Kylevdm/esp-power-hub/ESP Power Hub v2.kicad_pcb

## KiCad design ESP Power Hub v2.kicad_pcb (2026-02-04)

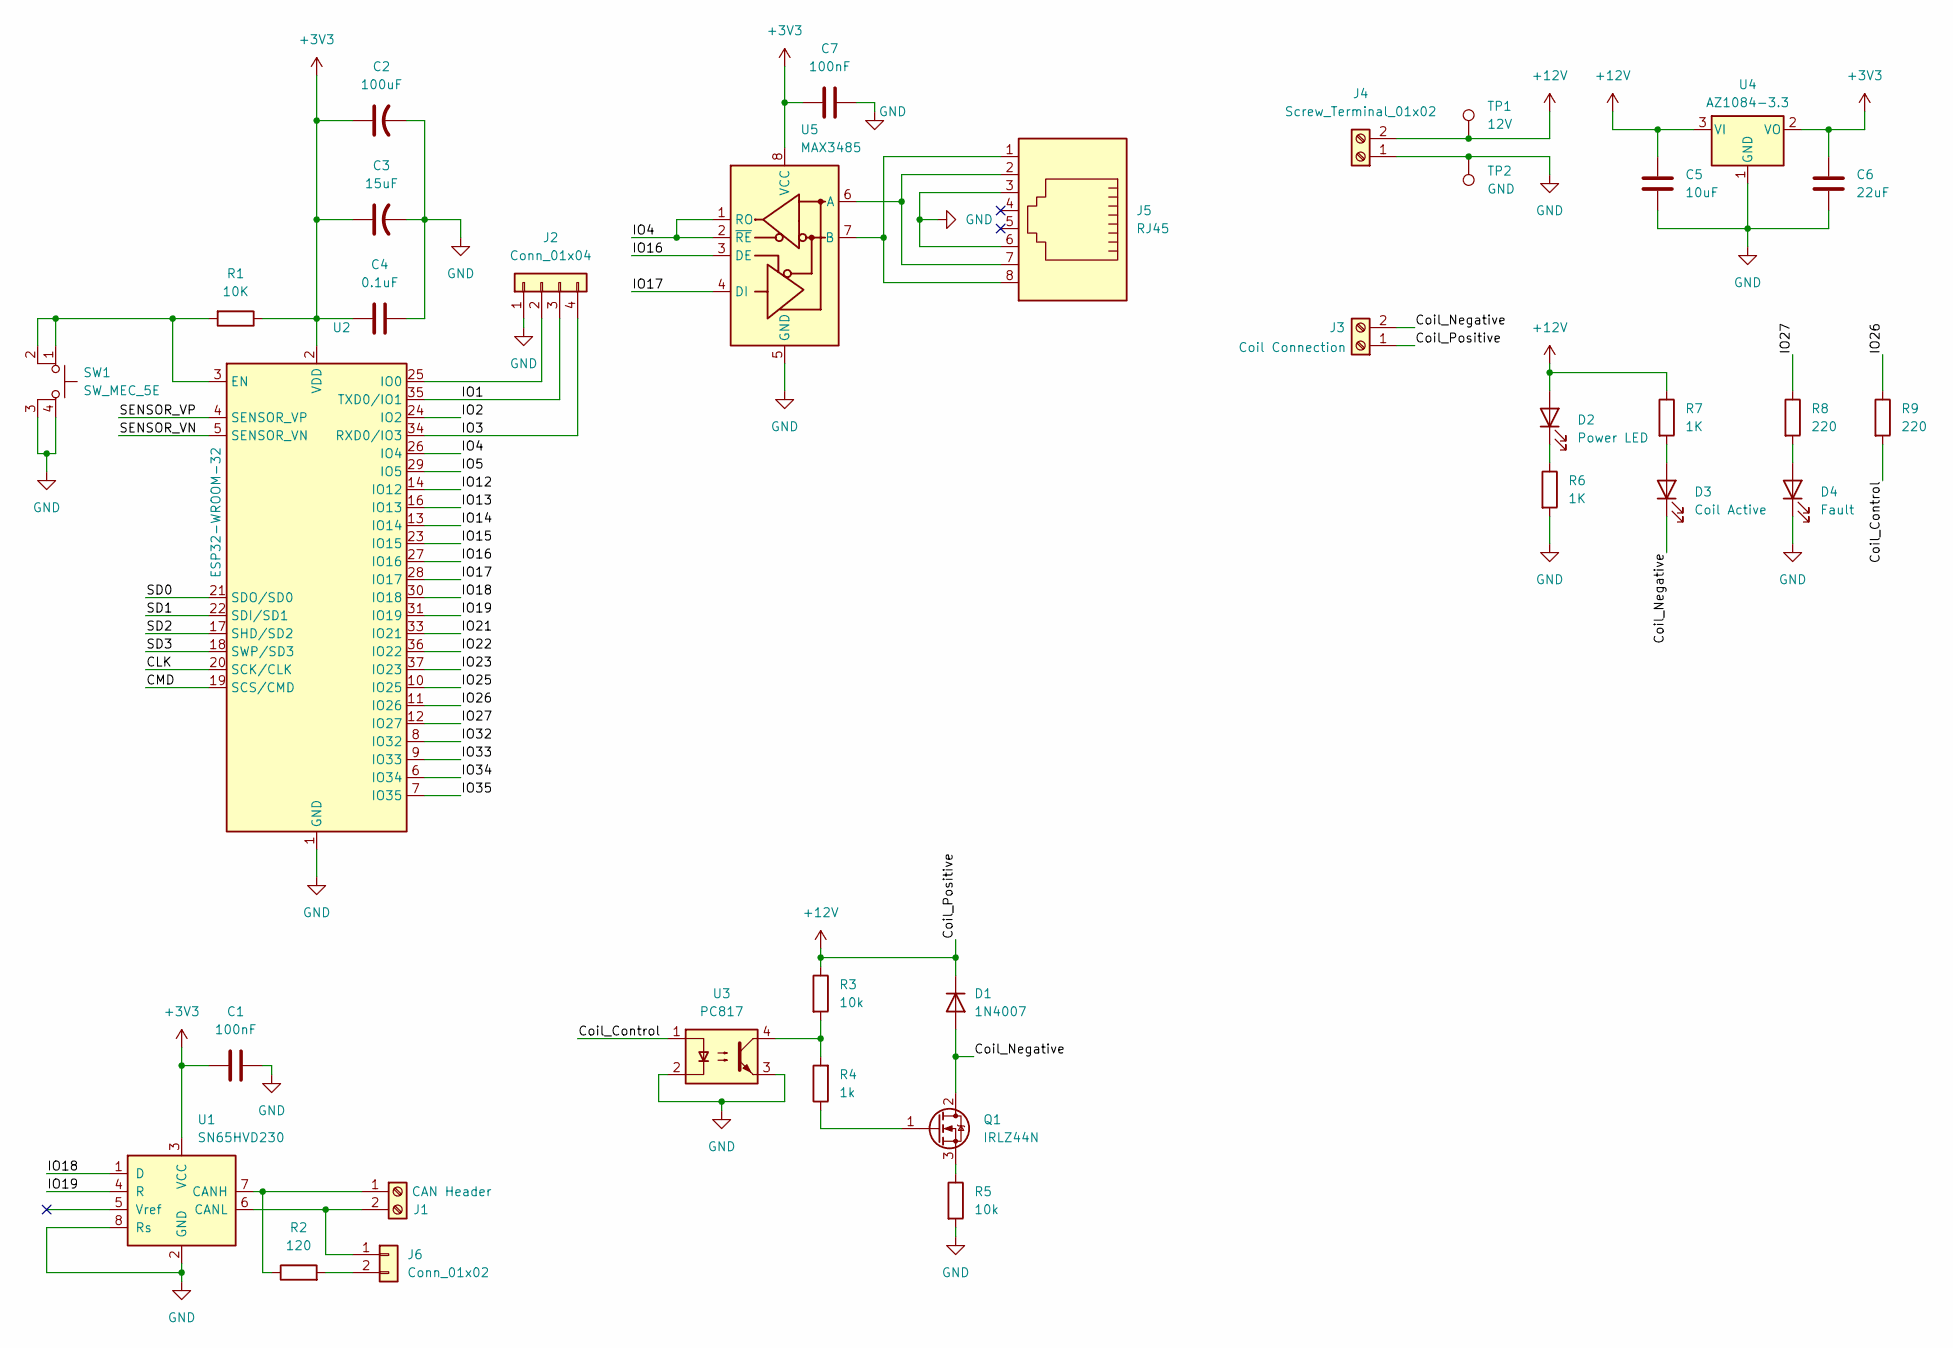
[picture p1: schematic ESP Power Hub v2.kicad_sch]

Parts:
C1, C7: 100nF; C_0603_1608Metric
C2: 100uF; C_Radial_D5.0mm_H7.0mm_P2.00mm
C3: 15uF; C_Radial_D4.0mm_H5.0mm_P1.50mm
C4: 0.1uF; C_0603_1608Metric
C5: 10uF; C_0603_1608Metric
C6: 22uF; C_0603_1608Metric
D1: 1N4007; D_DO-41_SOD81_P10.16mm_Horizontal
D2: Power LED; LED_D5.0mm
D3: Coil Active; LED_D5.0mm
D4: Fault; LED_D5.0mm
J1: CAN Header; TerminalBlock_MaiXu_MX126-5.0-02P_1x02_P5.00mm
J2: Conn_01x04; PinHeader_1x04_P2.54mm_Vertical
J3: Coil Connection; TerminalBlock_MaiXu_MX126-5.0-02P_1x02_P5.00mm
J4: Screw_Terminal_01x02; TerminalBlock_MaiXu_MX126-5.0-02P_1x02_P5.00mm
J5: RJ45; RJ45_Amphenol_54602-x08_Horizontal
J6: Conn_01x02; PinSocket_1x02_P2.54mm_Vertical
Q1: IRLZ44N; TO-220-3_Vertical
R1: 10K; R_0603_1608Metric
R2: 120; R_0603_1608Metric
R3, R5: 10k; R_0805_2012Metric
R4: 1k; R_0805_2012Metric
R6, R7: 1K; R_0603_1608Metric
R8, R9: 220; R_0603_1608Metric
SW1: SW_MEC_5E; SW_MEC_5GSH9
TP1: 12V; TestPoint_THTPad_D2.0mm_Drill1.0mm
TP2: GND; TestPoint_THTPad_D2.0mm_Drill1.0mm
U1: SN65HVD230; SOIC-8_3.9x4.9mm_P1.27mm
U2: ESP32-WROOM-32
U3: PC817; DIP-4_W7.62mm
U4: AZ1084-3.3; TO-252-2
U5: MAX3485; SOIC-8_3.9x4.9mm_P1.27mm

Connections:
+3V3: C1.2, C2.1, C3.1, C4.1, C6.1, C7.2, R1.1, U1.3 (VCC), U2.2 (VDD), U4.2 (VO), U5.8 (VCC)
+12V: C5.1, D1.1 (K), D2.2 (A), J3.1, J4.2, R3.1, R7.1, TP1.1, U4.3 (VI)
/CLK: U2.20 (SCK/CLK)
/CMD: U2.19 (SCS/CMD)
/Coil_Control: R9.2, U3.1
/Coil_Negative: D1.2 (A), D3.1 (K), J3.2, Q1.2 (D)
/IO1: J2.3, U2.35 (TXD0/IO1)
/IO2: U2.24 (IO2)
/IO3: J2.4, U2.34 (RXD0/IO3)
/IO4: U2.26 (IO4), U5.1 (RO), U5.2 (~RE)
/IO5: U2.29 (IO5)
/IO12: U2.14 (IO12)
/IO13: U2.16 (IO13)
/IO14: U2.13 (IO14)
/IO15: U2.23 (IO15)
/IO16: U2.27 (IO16), U5.3 (DE)
/IO17: U2.28 (IO17), U5.4 (DI)
/IO18: U1.1 (D), U2.30 (IO18)
/IO19: U1.4 (R), U2.31 (IO19)
/IO21: U2.33 (IO21)
/IO22: U2.36 (IO22)
/IO23: U2.37 (IO23)
/IO25: U2.10 (IO25)
/IO26: R9.1, U2.11 (IO26)
/IO27: R8.1, U2.12 (IO27)
/IO32: U2.8 (IO32)
/IO33: U2.9 (IO33)
/IO34: U2.6 (IO34)
/IO35: U2.7 (IO35)
/SD0: U2.21 (SDO/SD0)
/SD1: U2.22 (SDI/SD1)
/SD2: U2.17 (SHD/SD2)
/SD3: U2.18 (SWP/SD3)
/SENSOR_VN: U2.5 (SENSOR_VN)
/SENSOR_VP: U2.4 (SENSOR_VP)
GND: C1.1, C2.2, C3.2, C4.2, C5.2, C6.2, C7.1, D4.1 (K), J2.1, J4.1, J5.3, J5.6, R5.2, R6.2, SW1.3 (K), SW1.4 (A), TP2.1, U1.2 (GND), U1.8 (Rs), U2.1 (GND), U2.15 (GND), U2.38 (GND), U2.39 (GND), U3.2, U3.3, U4.1 (GND), U5.5 (GND)
unnamed: D2.1 (K), R6.1
unnamed: D3.2 (A), R7.2
unnamed: D4.2 (A), R8.2
unnamed: J1.1, R2.1, U1.7 (CANH)
unnamed: J1.2, J6.1, U1.6 (CANL)
unnamed: J2.2, U2.25 (IO0)
unnamed: J6.2, R2.2
unnamed: Q1.1 (G), R4.1
unnamed: Q1.3 (S), R5.1
unnamed: R3.2, R4.2, U3.4
unnamed: R1.2, SW1.1, SW1.2, U2.3 (EN)
unnamed: J5.2, J5.7, U5.6 (A)
unnamed: J5.1, J5.8, U5.7 (B)

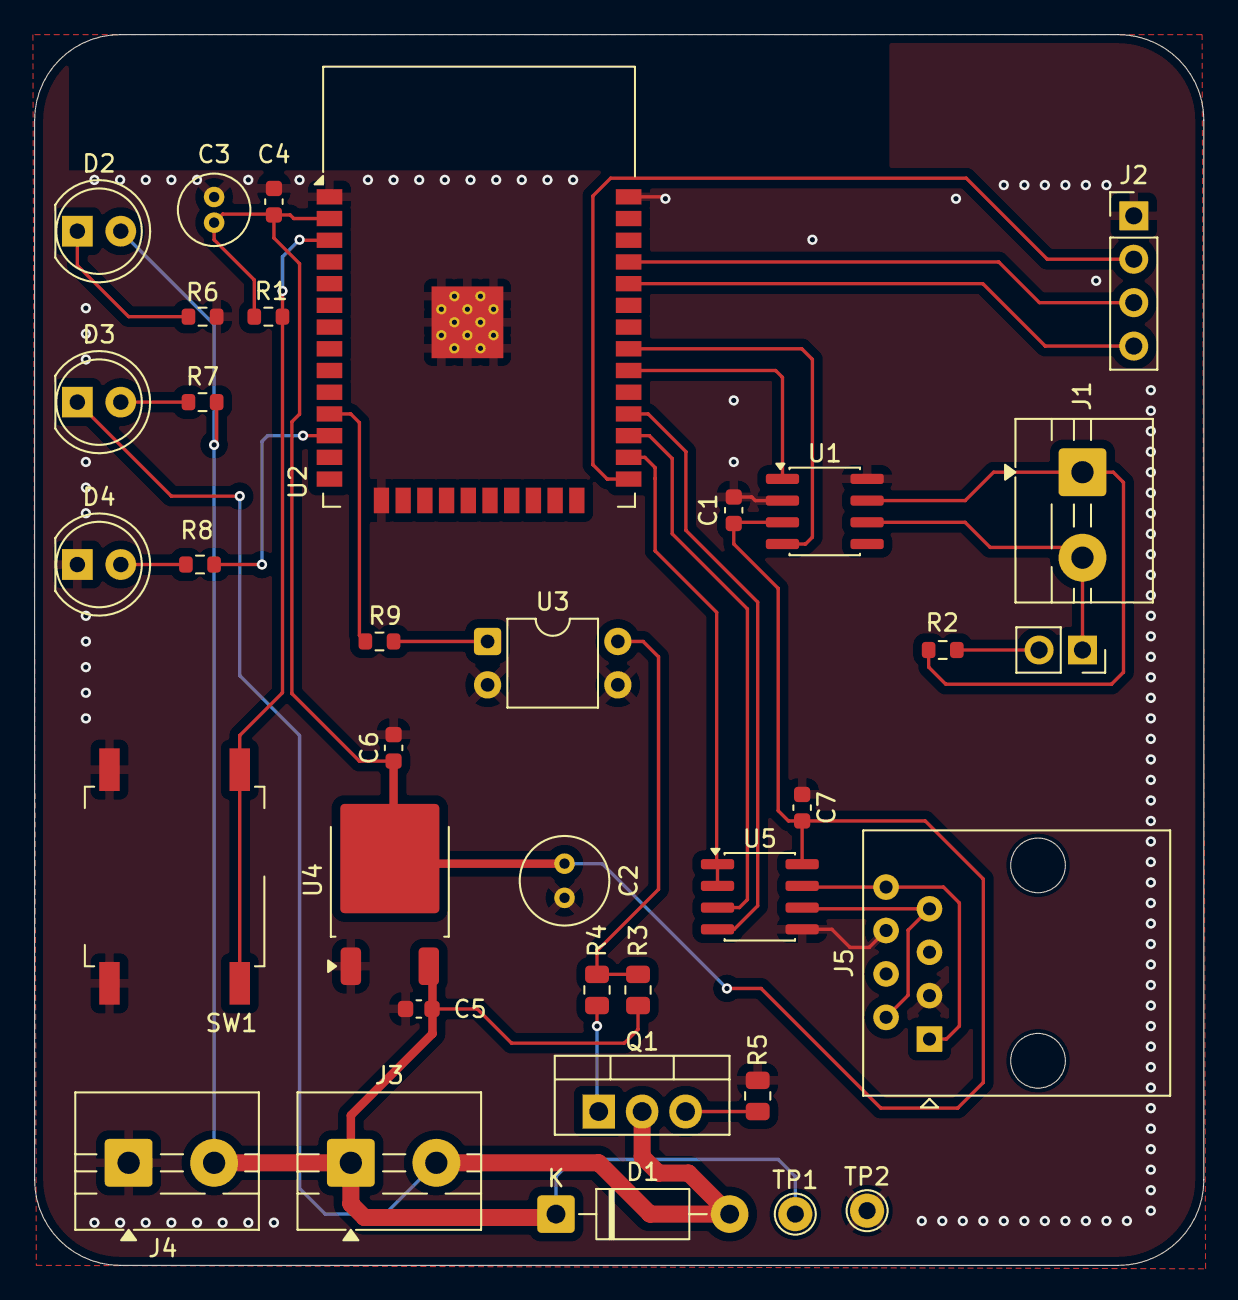
[picture p2: board ESP Power Hub v2.kicad_pcb from above]

Board: 2 copper layers, 68.4 x 72.0 mm, 35 parts (0 on the bottom side), 27 nets.
