Kylevdm/esp-power-hub/(commit log)

2026-02-04 Add files via upload
    Initial design upload
    [ESP Power Hub v2.kicad_pcb, ESP Power Hub v2.kicad_sch]
2026-06-03 Add ESPHome firmware for T-CAN485 with charge controller
    Phase 1 firmware for the ESP Power Hub using a LilyGo T-CAN485 dev board:
    - Main ESPHome config with T-CAN485 pin mapping (CAN, RS485, relay, LED)
    - Seplos V3 BMS integration via modbus_controller with reusable pack template
    - Emerson/Vertiv R48-3000e3 rectifier via existing external component
    - Custom charge_controller component with:
    - Autonomous charging state machine (STANDBY/BULK/ABSORB/FLOAT/ALARM)
    - Safety logic running every loop() iteration (~16ms)
    - Cross-pack BMS aggregation (min/max cell voltage, temperature, SOC)
    - Relay control with fail-safe open default
    - Configurable parameters via HA number entities
    - Enti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
    [charge_controller.cpp, charge_controller.h]
2026-06-04 Fix 6 bugs found in code review of charge controller
    1. ALARM state was inescapable: loop() gated update_state_machine_()
    behind state != ALARM, but the only ALARM exit path lived inside
    that function. Removed the gate so the ALARM case can run.
    2. Charging never started when SOC >= rebulk_soc: STANDBY only
    transitioned to BULK when SOC < threshold. Added STANDBY->FLOAT
    path for batteries already above rebulk threshold.
    3. Number/Switch entities never initialized: new_number/new_switch
    don't call register_component, so Component::setup() never ran.
    Added explicit register_component calls + enabled restore_value.
    4. Comms timeout only watched 2 of 6 pack sensors: added ca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
    [charge_controller.cpp, charge_controller.h]
